ishquark13/Senior_Project/Documents/ocarina_link.gif

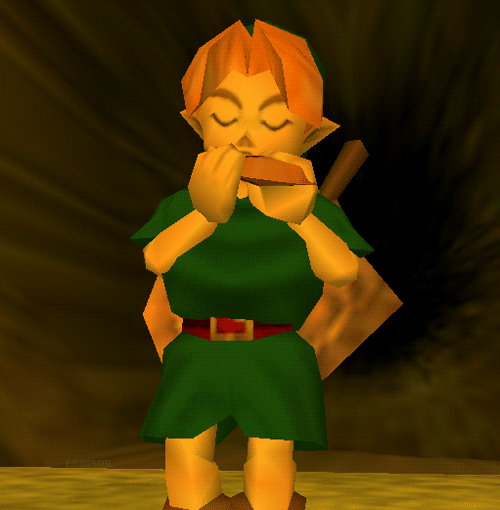
Documents/ocarina_link.gif
