ishquark13/Senior_Project/Hardware Projects/Sensors/Sensors.PcbDoc.htm

Reporting Options

# File in Previous Format

Date | : | 12/6/2017
Time | : | 8:59:06 PM
Filename | : | C:\Users\Adrian\Documents\GitHub\Senior_Project\Hardware Projects\Sensors\Sensors.PcbDoc

Version | Warning

This file was generated by an earlier version of the software
