ishquark13/Senior_Project/Hardware Projects/Senior_Project_PCB/DSP_Board.PcbDoc.htm

Reporting Options

# File in Previous Format

Date | : | 11/26/2017
Time | : | 10:20:54 AM
Filename | : | C:\Users\Adrian\Documents\GitHub\Senior_Project\Hardware Projects\Senior_Project_PCB\DSP_Board.PcbDoc

Version | Warning

This file was generated by an earlier version of the software
