ishquark13/Senior_Project/Hardware Projects/TMS320F28335GF/TMS320F28335GF.PcbDoc.htm

Reporting Options

# File in Previous Format

Date | : | 9/18/2017
Time | : | 1:07:27 PM
Filename | : | C:\Users\Adrian\Documents\GitHub\Senior_Project\TMS320F28335GF\TMS320F28335GF.PcbDoc

Version | Warning

This file was generated by an earlier version of the software
