ishquark13/Senior_Project/Hardware Projects/Senior_DoorLock/Project Outputs for Senior_DoorLock/Net Status - Senior_DoorLock.html

Altium customize

# Net Status Report

Date: | | 10/19/2017
Time: | | 2:37:35 AM
Elapsed Time: | | 00:00:00
Filename: | | C:\Users\Adrian\Altium\Projects\Senior_DoorLock\Senior_DoorLock.PcbDoc
Units: | | mmmils

Nets | Layer | Length
12.0V | Signal Layers Only | 0mils
5.0V | Signal Layers Only | 0mils
GND | Signal Layers Only | 0mils
Lock_Enable | Signal Layers Only | 0mils
MagSense | Signal Layers Only | 0mils
NetP3_2 | Signal Layers Only | 0mils
NetR1_1 | Signal Layers Only | 0mils
NetR1_2 | Signal Layers Only | 0mils
NetR2_1 | Signal Layers Only | 0mils
NetR2_2 | Signal Layers Only | 0mils

Back to top
