ishquark13/Senior_Project/Hardware Projects/Senior_Project_PCB/DSP_Board_AJA.PcbDoc.htm

Reporting Options

# File in Newer Format

Date | : | 12/7/2017
Time | : | 12:00:39 AM
Filename | : | C:\Users\Ish's Master Race PC\Documents\SeniorGithub\Senior_Project\Hardware Projects\Senior_Project_PCB\DSP_Board_AJA.PcbDoc

Version | Warning
Release 17.0 | CAUTION - Component parameters added.
Release 17.0 | CAUTION - Supports of backdrilling

This file was generated by a later version of the software
