ishquark13/Senior_Project/Documents/DSP_Flow.jpg

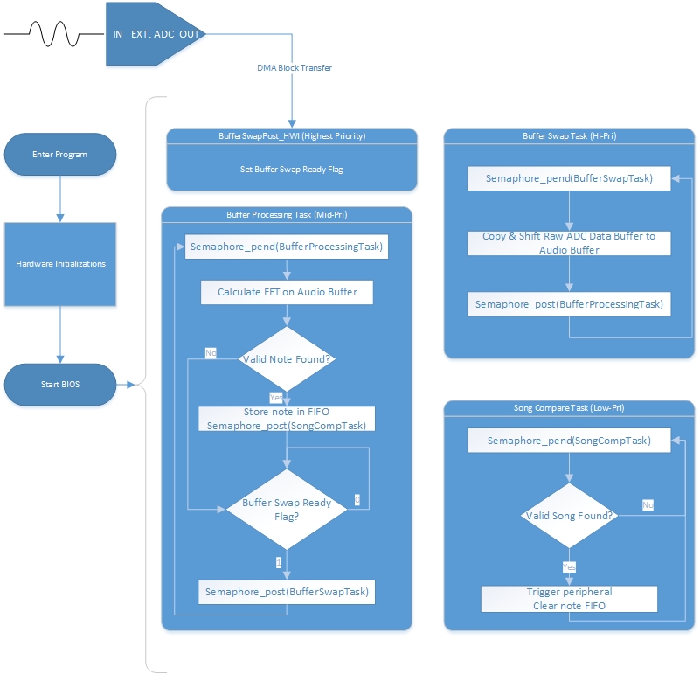
Documents/DSP_Flow.jpg
