ishquark13/Senior_Project/Documents/ESP_Flow.jpg

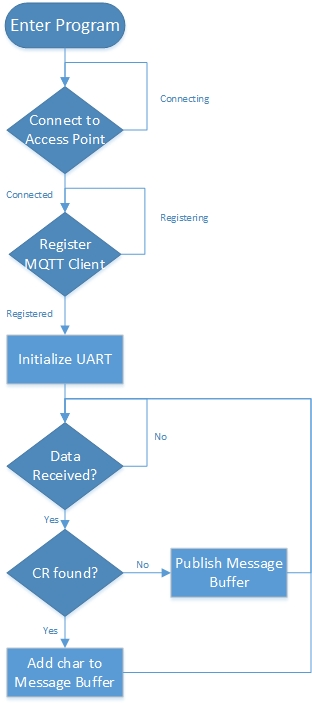
Documents/ESP_Flow.jpg
