ishquark13/Senior_Project/Documents/hardwareOverview.jpg

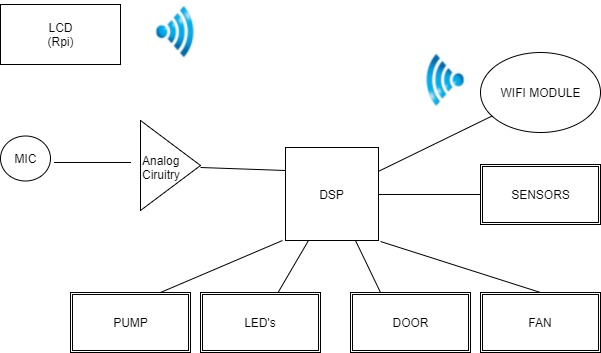
Documents/hardwareOverview.jpg
