ishquark13/Senior_Project/Hardware Projects/SolidWorks/Kokiri.png

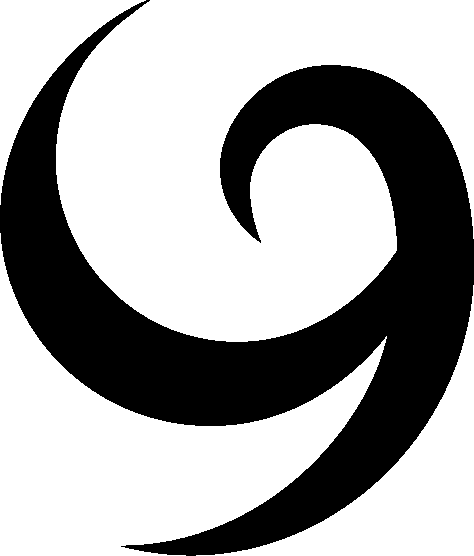
Hardware Projects/SolidWorks/Kokiri.png
