ishquark13/Senior_Project/Hardware Projects/SolidWorks/RoyalCrest.png

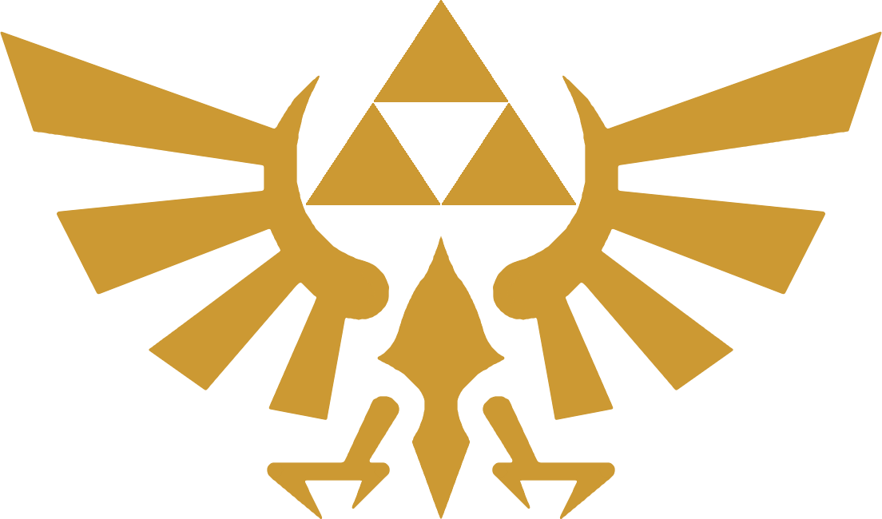
Hardware Projects/SolidWorks/RoyalCrest.png
