ishquark13/Senior_Project/Hardware Projects/SolidWorks/sword&shield.jpg

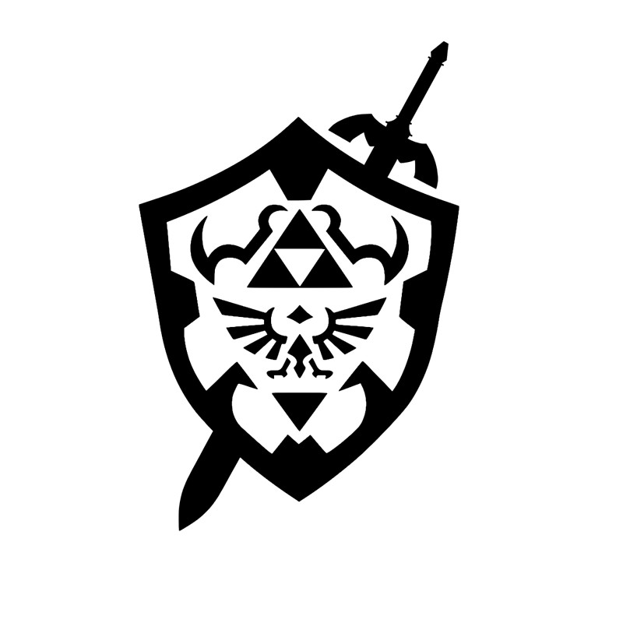
Hardware Projects/SolidWorks/sword&shield.jpg
