ishquark13/Senior_Project/Hardware Projects/SolidWorks/triforce.png

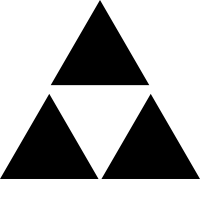
Hardware Projects/SolidWorks/triforce.png
