ishquark13/Senior_Project/Documents/partsList.xlsx

4xTL07 | **
resistors
capacitors
polarized caps
3.5mm audio jack
jumper wires
Pump | http://www.mouser.com/ProductDetail/Adafruit/1150/?qs=GURawfaeGuC56yozG16bcg%3D%3D
ADC | https://www.digikey.com/product-detail/en/ADS8320EB%2F2K5/296-38858-1-ND/5142976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 |  |  |  |  |  |  | **
Fan | https://www.amazon.com/ARCTIC-F12-Standard-Noise-Case/dp/B002KTVFTE?s=electronics
LED array | https://www.amazon.com/Super-Bright-RGB-LED-matrix/dp/B0068K01QE
DSP chip
Mic
Door Lock | https://www.amazon.com/dp/B012KISKU6?creative=395033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
LCD Disp
Bglebone
Item Number | Item Name | Footprint | Quantity | Purpose | Manufacturer | Source | Price
1 | TMS320F28335 | 176-Pin QFP | 1 | Digital Signal Processor | TI
2 | ADS8320 | MSOP-8 | 1 | Audio Sampler | TI
3 | TPS70351 | 24-Pin PowerPAD TSSOP | 1 | 5.0V to 3.3V/1.8V Power Delivery and Sequencing | TI
4 | Epson Oscillator | 4-Pin (Unique) | 1 | Oscillator Source for DSP Clock
5 |  |  | 2 | Audio BandPass Filter Op-Amps
6 |  |  | 1 | Audio PreAmp Op-Amps
7
8
9
10
11
12
13
14
15
16
17
18
19
20
