ishquark13/Senior_Project/Hardware Projects/SolidWorks/HomeModel.SLDASM

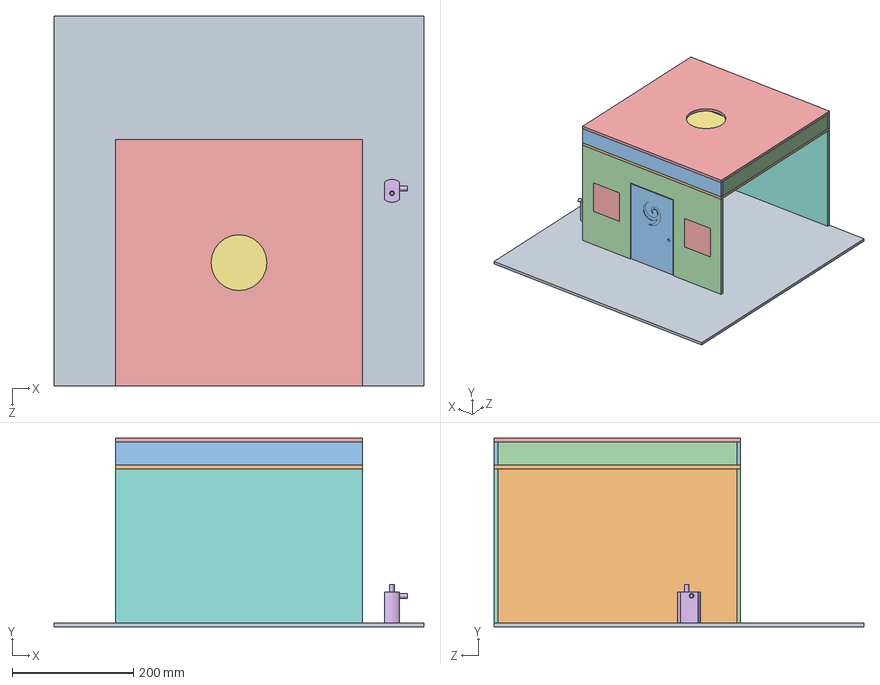
[picture p21: CAD file, 2017-11-25]
Hardware Projects/SolidWorks/HomeModel.SLDASM
609.6 x 311.1 x 609.6 mm
BaseBoard
Ceiling
FrontDoor
FrontWall
FrontWindow x 2
DSP_Board_AJA
Fan
BackWall
Senior_DoorLock
SideWall
RoofFrontBack x 2
RoofSide x 2
RoofTop
Pump
