ishquark13/Senior_Project/Hardware Projects/Senior_DoorLock/Senior_DoorLock.step

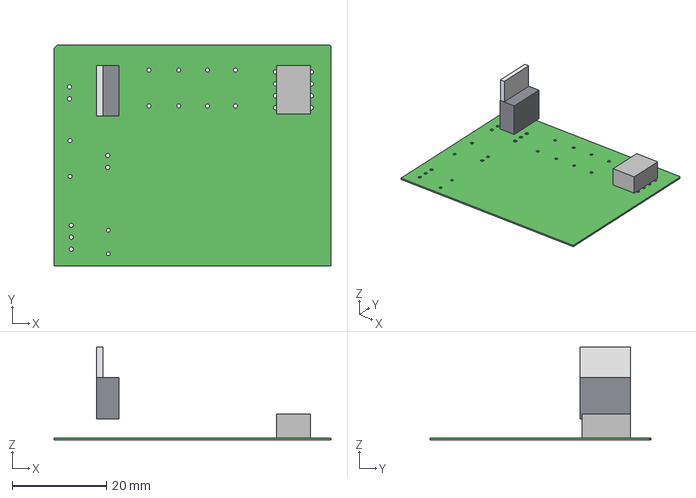
[picture p22: CAD file, 2017-11-25]
Hardware Projects/Senior_DoorLock/Senior_DoorLock.step
58.9 x 47.0 x 19.7 mm
