ishquark13/Senior_Project/Hardware Projects/Senior_Project_PCB/DSP_Board_AJA.step

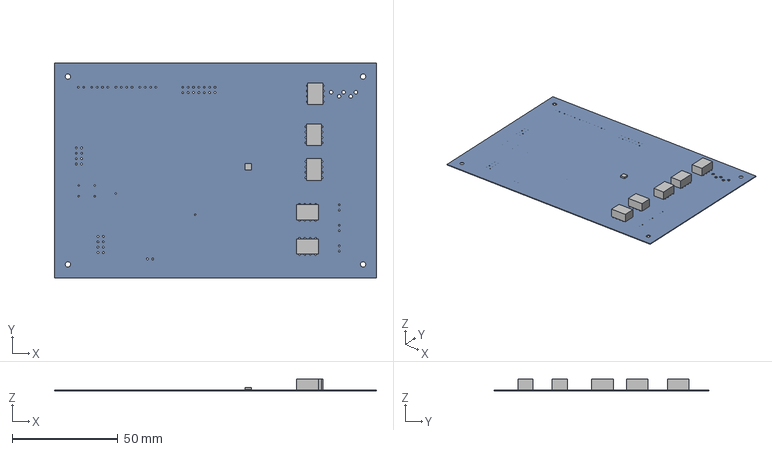
[picture p23: CAD file, 2017-11-15]
Hardware Projects/Senior_Project_PCB/DSP_Board_AJA.step
152.4 x 101.6 x 5.49 mm
