ishquark13/Senior_Project/Hardware Projects/SolidWorks/RoofSide.SLDPRT

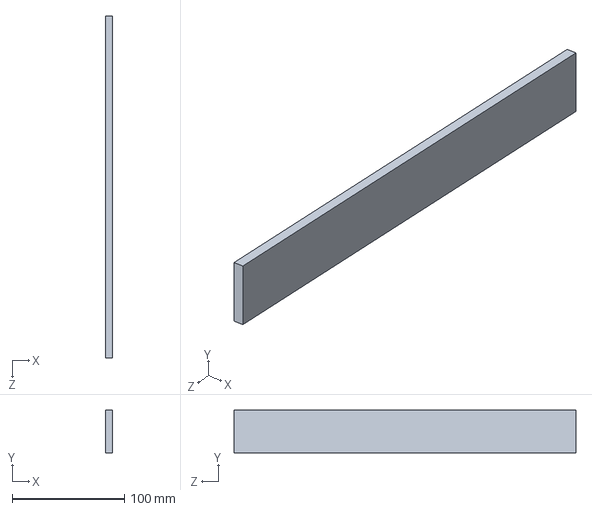
[picture p24: CAD file, 2017-12-04]
Hardware Projects/SolidWorks/RoofSide.SLDPRT
6.35 x 38.1 x 304.8 mm
