ishquark13/Senior_Project/Hardware Projects/SolidWorks/RoofTop.SLDPRT

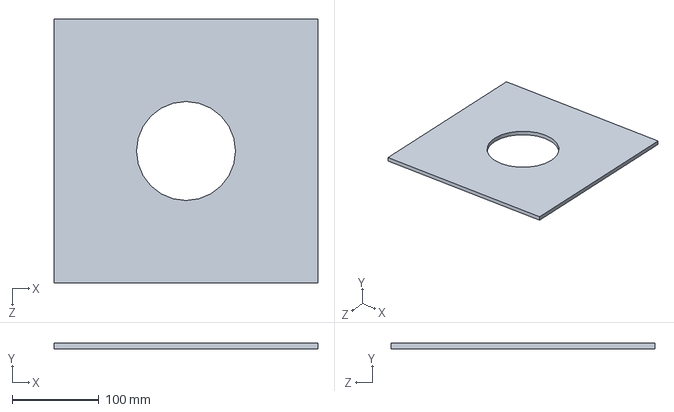
[picture p25: CAD file, 2017-12-04]
Hardware Projects/SolidWorks/RoofTop.SLDPRT
304.8 x 6.35 x 304.8 mm
