ishquark13/Senior_Project/Hardware Projects/SolidWorks/FrontDoor.SLDPRT

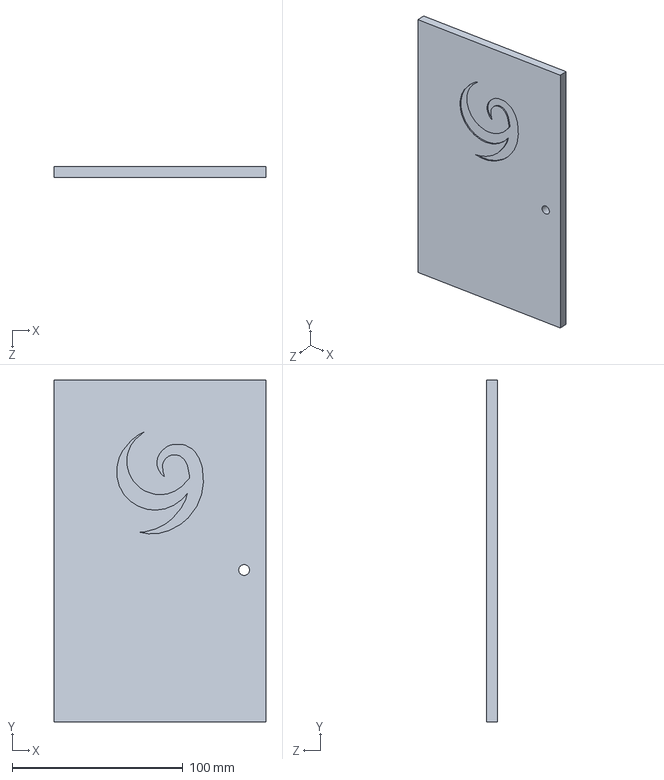
[picture p26: CAD file, 2017-11-25]
Hardware Projects/SolidWorks/FrontDoor.SLDPRT
123.8 x 200.0 x 6.35 mm
