ishquark13/Senior_Project/Hardware Projects/SolidWorks/Fan.SLDPRT

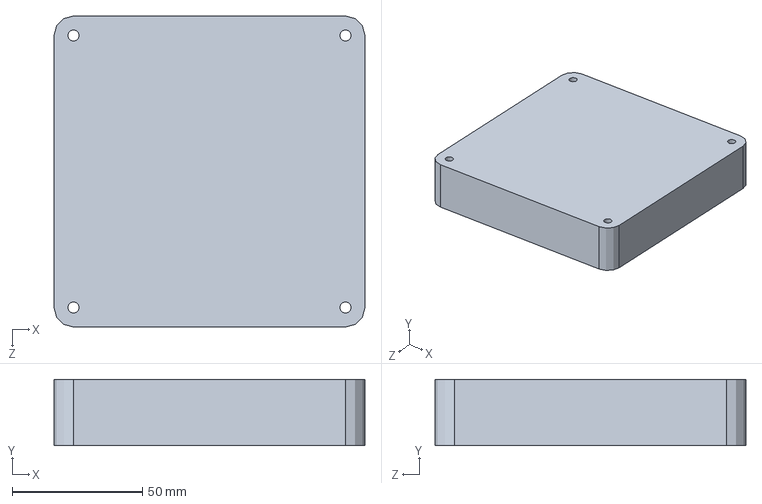
[picture p27: CAD file, 2017-11-25]
Hardware Projects/SolidWorks/Fan.SLDPRT
119.4 x 25.4 x 119.4 mm
