ishquark13/Senior_Project/Hardware Projects/SolidWorks/RoofFrontBack.SLDPRT

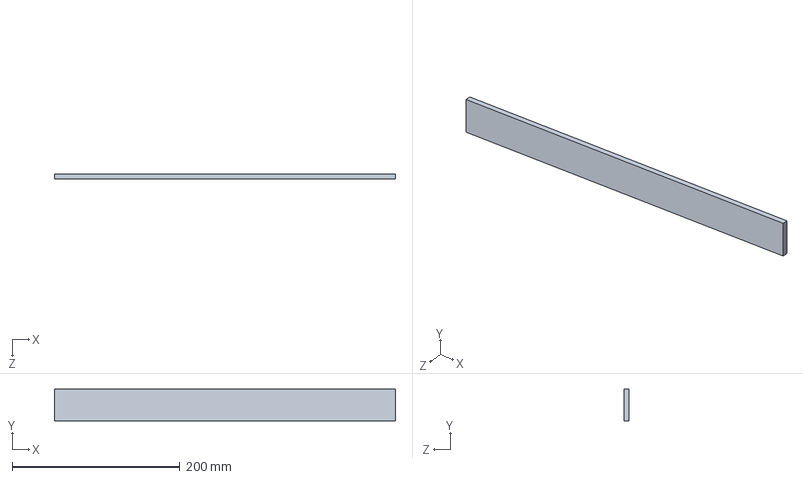
[picture p28: CAD file, 2017-11-25]
Hardware Projects/SolidWorks/RoofFrontBack.SLDPRT
406.4 x 38.1 x 6.35 mm
