ishquark13/Senior_Project/Hardware Projects/SolidWorks/Ceiling.SLDPRT

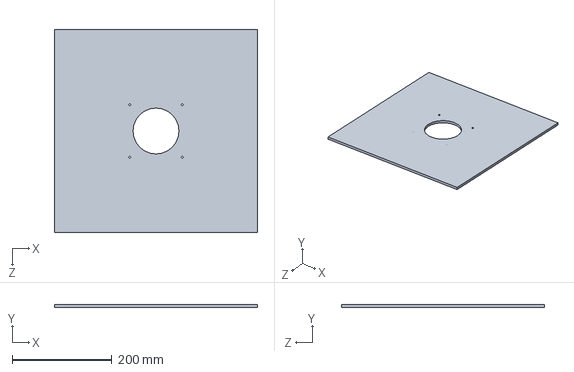
[picture p29: CAD file, 2017-11-25]
Hardware Projects/SolidWorks/Ceiling.SLDPRT
406.4 x 6.35 x 406.4 mm
