ishquark13/Senior_Project/Hardware Projects/SolidWorks/BackWall.SLDPRT

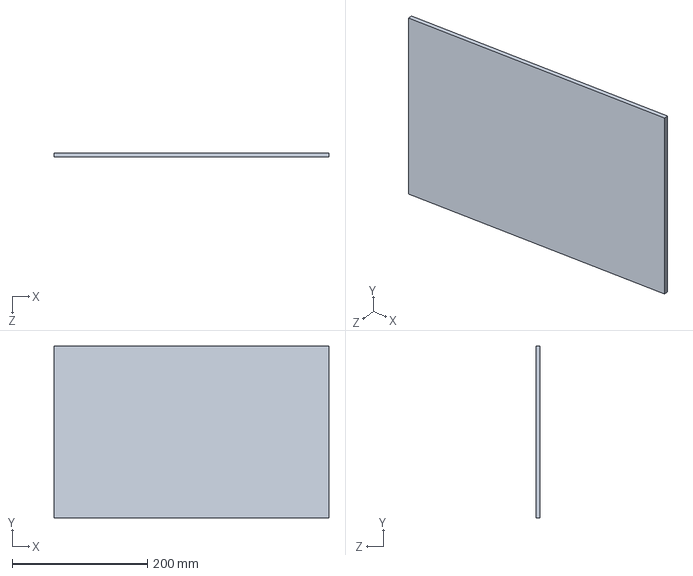
[picture p30: CAD file, 2017-11-25]
Hardware Projects/SolidWorks/BackWall.SLDPRT
406.4 x 254.0 x 6.35 mm
