ishquark13/Senior_Project/Hardware Projects/SolidWorks/BaseBoard.SLDPRT

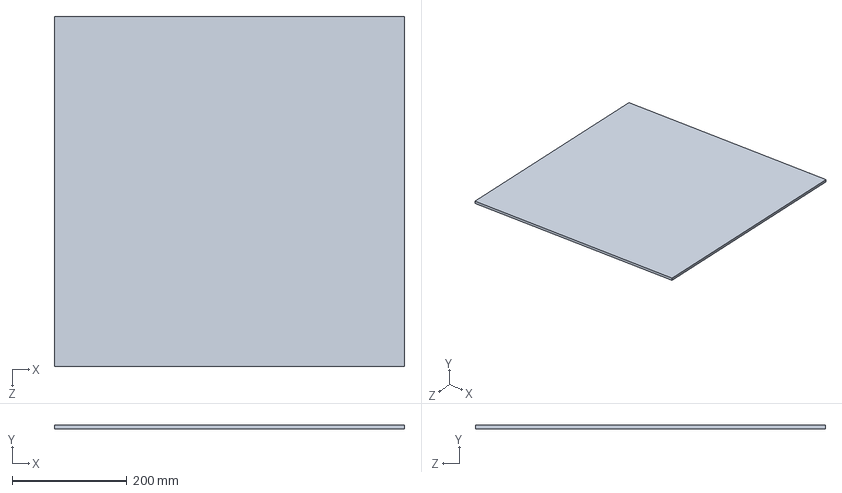
[picture p31: CAD file, 2017-11-25]
Hardware Projects/SolidWorks/BaseBoard.SLDPRT
609.6 x 6.35 x 609.6 mm
