ishquark13/Senior_Project/Hardware Projects/SolidWorks/SideWall.SLDPRT

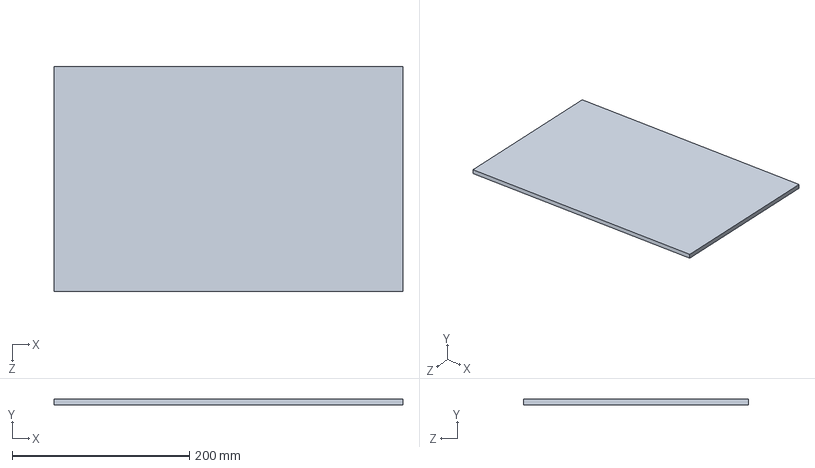
[picture p32: CAD file, 2017-11-25]
Hardware Projects/SolidWorks/SideWall.SLDPRT
393.7 x 6.35 x 254.0 mm
