ishquark13/Senior_Project/Hardware Projects/SolidWorks/FrontWall.SLDPRT

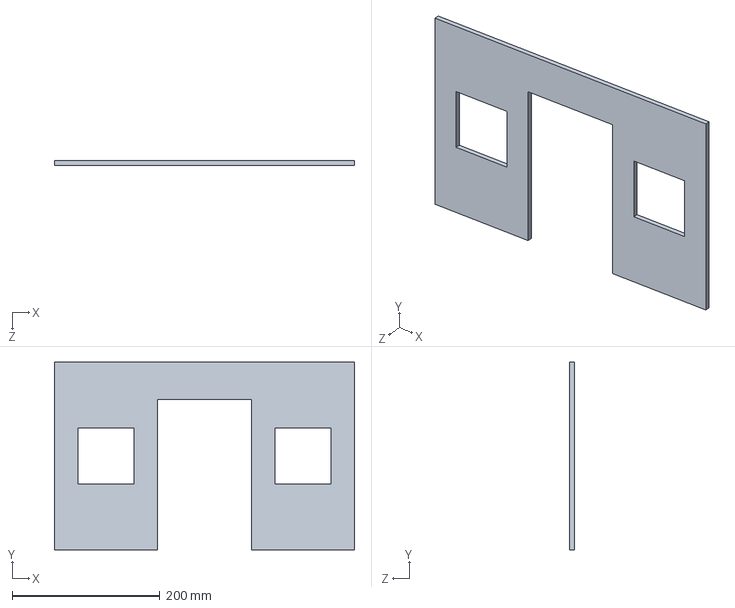
[picture p33: CAD file, 2017-11-25]
Hardware Projects/SolidWorks/FrontWall.SLDPRT
406.4 x 254.0 x 6.35 mm
