ishquark13/Senior_Project/Hardware Projects/SolidWorks/FrontWindow.SLDPRT

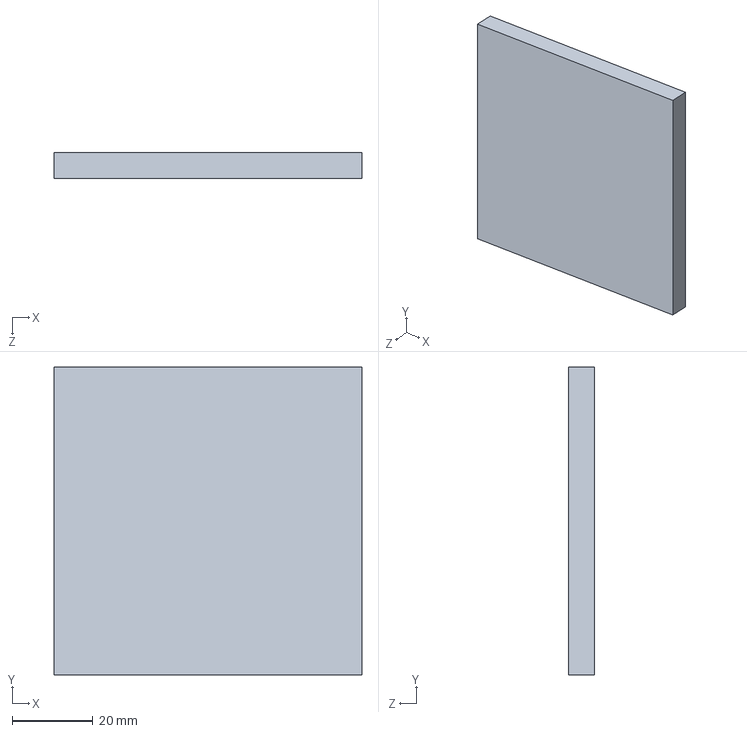
[picture p34: CAD file, 2017-11-25]
Hardware Projects/SolidWorks/FrontWindow.SLDPRT
76.2 x 76.2 x 6.35 mm
