ishquark13/Senior_Project/Hardware Projects/SolidWorks/Pump.SLDPRT

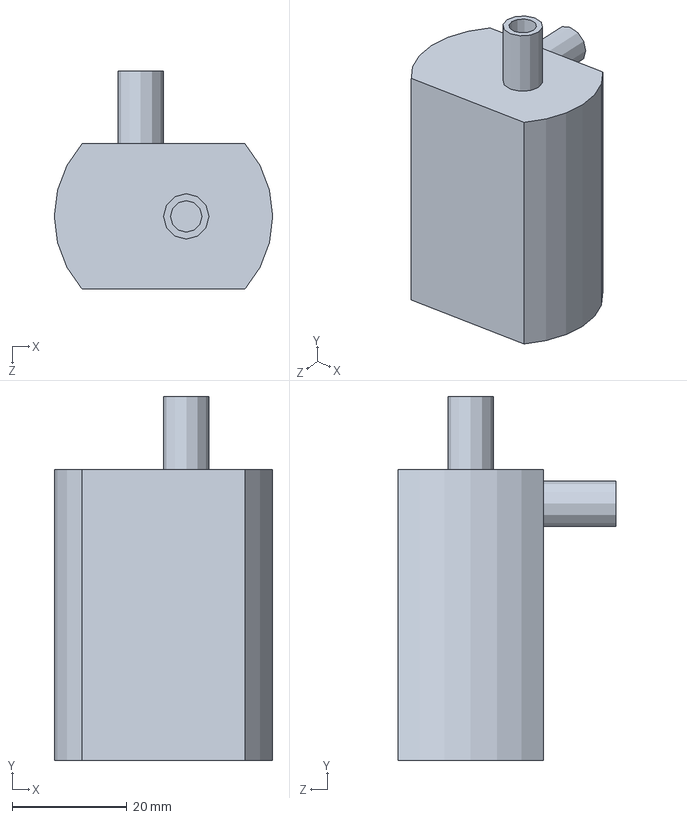
[picture p35: CAD file, 2017-11-25]
Hardware Projects/SolidWorks/Pump.SLDPRT
38.1 x 63.5 x 38.1 mm
