ishquark13/Senior_Project/(list of files, cad)

Other CAD files:
Software Projects/Ocarina_Home_Automation/src/sysbios/c28_Hwi_asm.obj
Software Projects/Ocarina_Home_Automation/src/sysbios/c28_TaskSupport_asm.obj
Software Projects/Ocarina_Home_Automation/src/sysbios/c28_IntrinsicsSupport_asm.obj
Software Projects/Ocarina_Home_Automation/src/sysbios/c28_Hwi_disp_asm.obj
Software Projects/Ocarina_Home_Automation/Debug/Common/DSP2833x_Spi.obj
Software Projects/Ocarina_Home_Automation/Debug/EEL4511 Libraries/src/EEL4511_CircBuff.obj
Software Projects/Ocarina_Home_Automation/Debug/RFFT/RFFT_f32s_mag.obj
Software Projects/Ocarina_Home_Automation/Debug/Common/DSP2833x_DMA.obj
Software Projects/Ocarina_Home_Automation/Debug/EEL4511 Libraries/src/EEL4511_MISC.obj
Software Projects/Ocarina_Home_Automation/Debug/RFFT/RFFT_f32.obj
Software Projects/Ocarina_Home_Automation/Debug/Common/DSP2833x_ADC_cal.obj
Software Projects/Ocarina_Home_Automation/Debug/EEL4511 Libraries/src/EEL4511_ADC.obj
Software Projects/Ocarina_Home_Automation/Debug/RFFT/RFFT_f32_sincostable.obj
Hardware Projects/SolidWorks/Senior_DoorLock.SLDPRT
Software Projects/Ocarina_Home_Automation/Debug/Common/DSP2833x_DefaultIsr.obj
Software Projects/Ocarina_Home_Automation/Debug/EEL4511 Libraries/src/EEL4511_GPIO.obj
Software Projects/Ocarina_Home_Automation/Debug/RFFT/RFFT_f32_phase.obj
Software Projects/Ocarina_Home_Automation/src/sysbios/BIOS.obj
Software Projects/Ocarina_Home_Automation/Debug/Common/DSP2833x_Mcbsp.obj
Software Projects/Ocarina_Home_Automation/Debug/EEL4511 Libraries/src/EEL4511_LCD.obj
Software Projects/Ocarina_Home_Automation/Debug/RFFT/RFFT_f32_mag.obj
Software Projects/Ocarina_Home_Automation/Debug/Common/DSP2833x_Adc.obj
Software Projects/Ocarina_Home_Automation/Debug/EEL4511 Libraries/src/EEL4511_SRAM.obj
Software Projects/Ocarina_Home_Automation/Debug/RFFT/RFFT_adc_f32.obj
Software Projects/Ocarina_Home_Automation/Debug/Common/DSP2833x_Xintf.obj
Software Projects/Ocarina_Home_Automation/Debug/EEL4511 Libraries/src/actuatorControl.obj
Software Projects/Ocarina_Home_Automation/Debug/RFFT/RFFT_adc_f32u.obj
Software Projects/Ocarina_Home_Automation/Debug/Common/DSP2833x_usDelay.obj
Software Projects/Ocarina_Home_Automation/Debug/EEL4511 Libraries/src/EEL4511_DAC.obj
Software Projects/Ocarina_Home_Automation/Debug/RFFT/RFFT_f32u.obj
Software Projects/Ocarina_Home_Automation/Debug/Common/DSP2833x_MemCopy.obj
Software Projects/Ocarina_Home_Automation/Debug/EEL4511 Libraries/src/USARTinit.obj
Software Projects/Ocarina_Home_Automation/Debug/Common/DSP2833x_I2C.obj
Software Projects/Ocarina_Home_Automation/Debug/EEL4511 Libraries/src/OneToOneI2CDriver.obj
Hardware Projects/SolidWorks/DSP_Board_AJA.SLDPRT
Software Projects/Ocarina_Home_Automation/Debug/Common/DSP2833x_Gpio.obj
Software Projects/Ocarina_Home_Automation/Debug/Common/DSP2833x_CpuTimers.obj
Software Projects/Ocarina_Home_Automation/Debug/Common/DSP2833x_Sci.obj
Software Projects/Ocarina_Home_Automation/Debug/Common/DSP2833x_SysCtrl.obj
Software Projects/Ocarina_Home_Automation/Debug/Common/DSP2833x_EPwm.obj
Software Projects/Ocarina_Home_Automation/Debug/Common/DSP2833x_GlobalVariableDefs.obj
Software Projects/Ocarina_Home_Automation/Debug/EEL4511 Libraries/EEL4511_ADC.obj
Software Projects/Ocarina_Home_Automation/Debug/EEL4511 Libraries/EEL4511_CircBuff.obj
Software Projects/Ocarina_Home_Automation/Debug/EEL4511 Libraries/EEL4511_DAC.obj
Software Projects/Ocarina_Home_Automation/Debug/EEL4511 Libraries/EEL4511_GPIO.obj
Software Projects/Ocarina_Home_Automation/Debug/EEL4511 Libraries/EEL4511_LCD.obj
Software Projects/Ocarina_Home_Automation/Debug/EEL4511 Libraries/EEL4511_MISC.obj
Software Projects/Ocarina_Home_Automation/Debug/EEL4511 Libraries/EEL4511_SRAM.obj
Software Projects/Ocarina_Home_Automation/Debug/EEL4511 Libraries/OneToOneI2CDriver.obj
