ishquark13/Senior_Project/Hardware Projects/Senior_Project_PCB/PCB_Printout.pdf

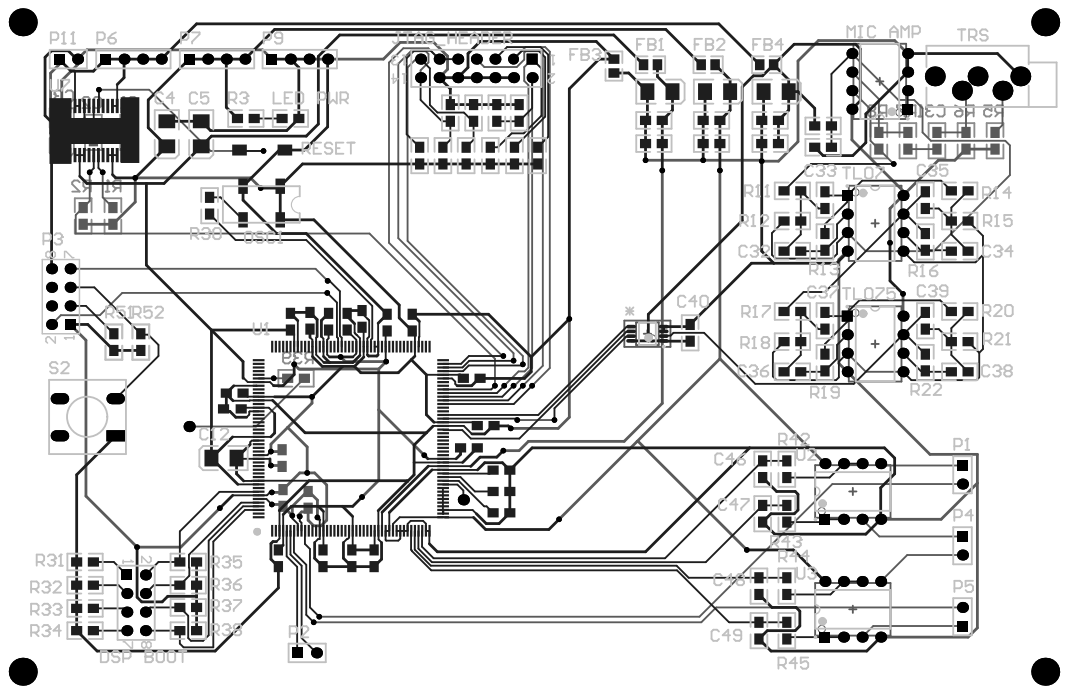
[picture p36: page 1]
