ishquark13/Senior_Project/Documents/Flowchart_v1.pdf

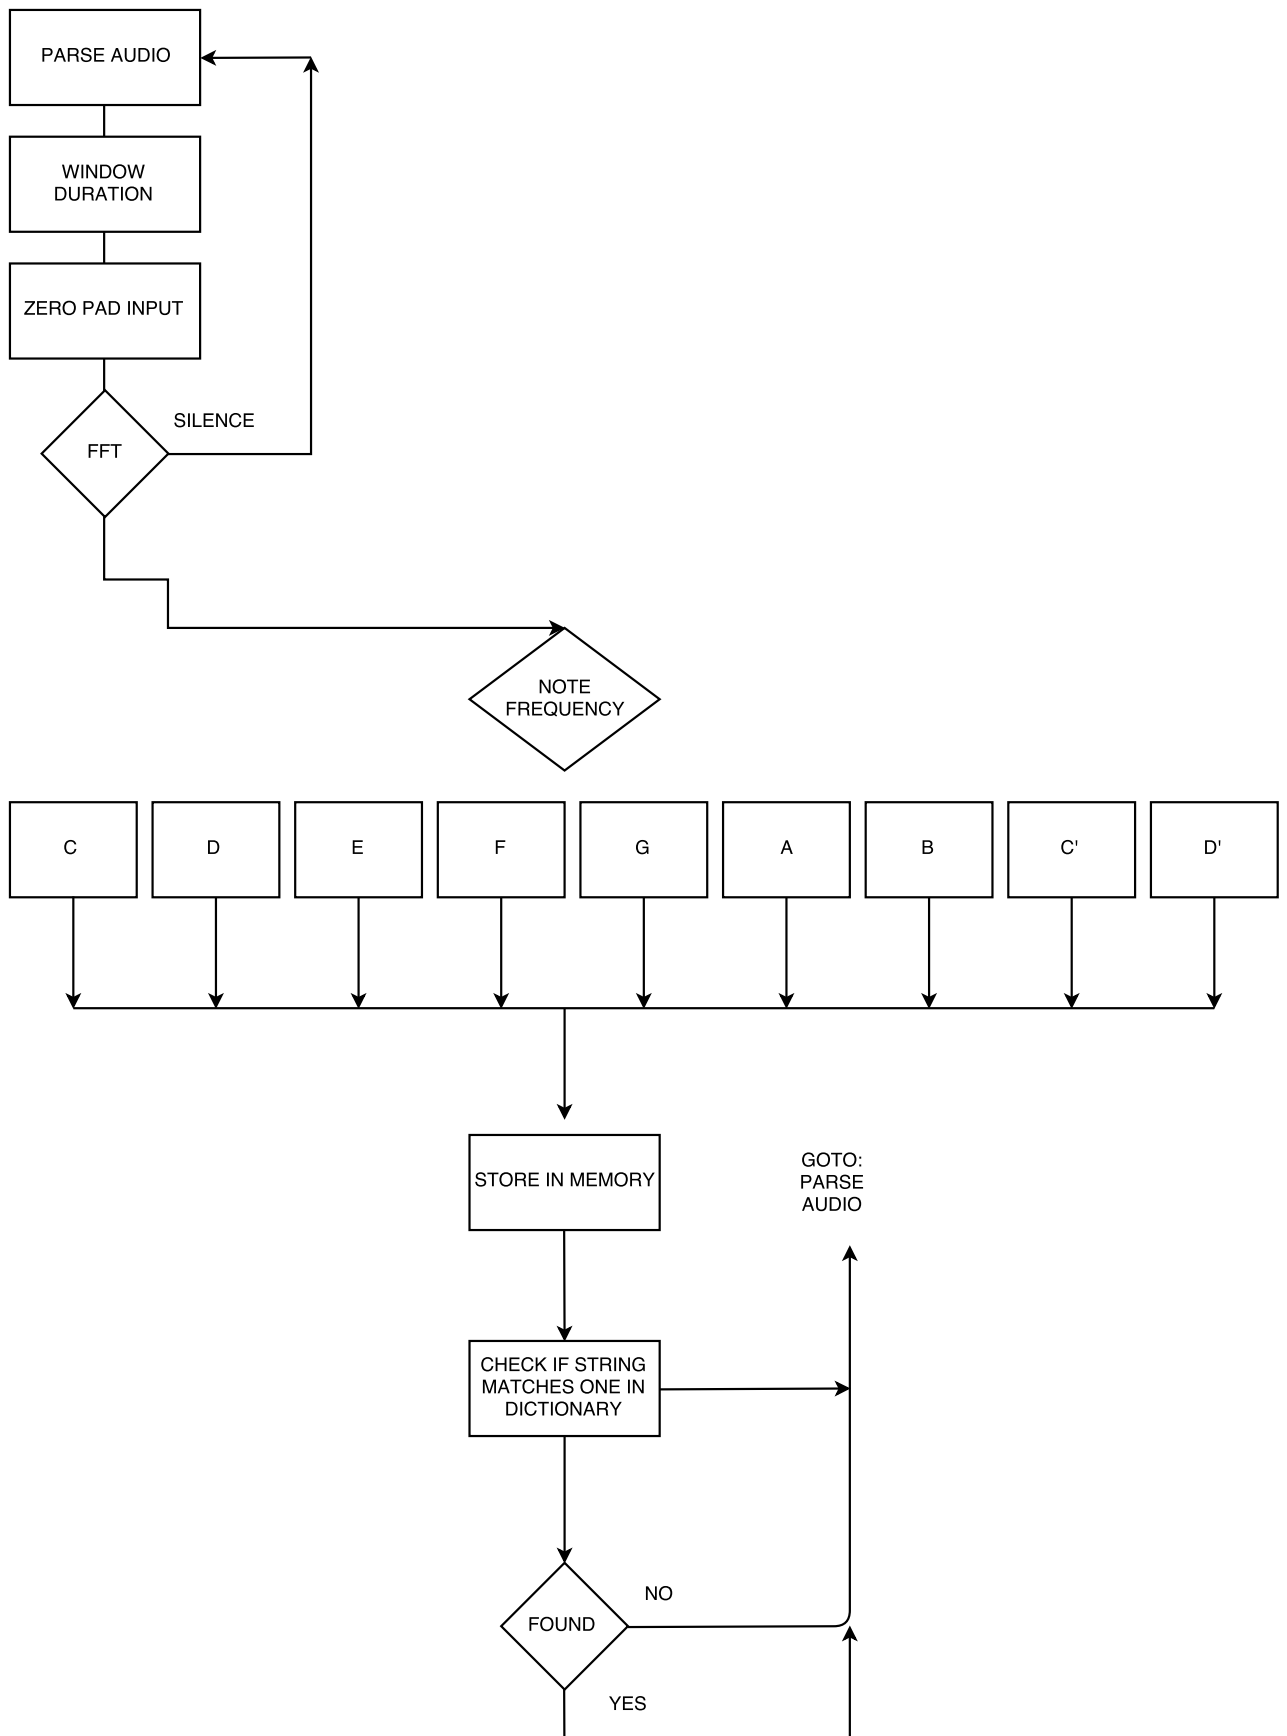
[picture p37: page 1]

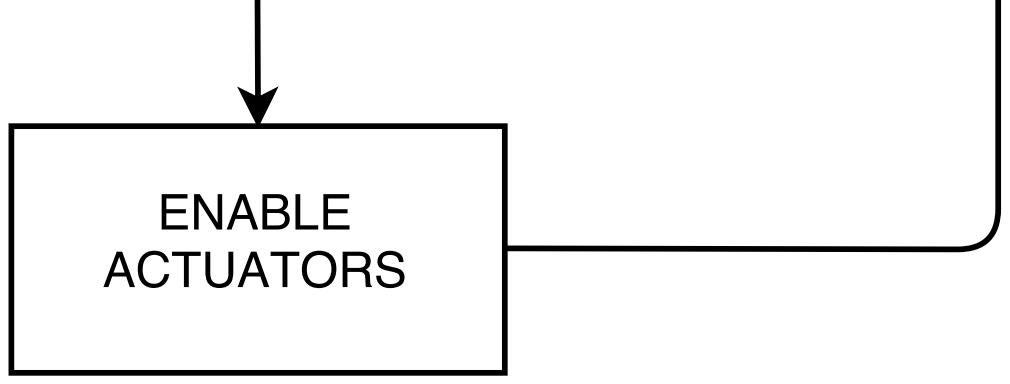
[picture p38: page 2]
