ishquark13/Senior_Project/(list of files, drawings)

Other design files:
Hardware Projects/Senior_Analog_PCB/CLASS_AB.PcbDoc
Hardware Projects/Senior_Analog_PCB/CLASS_AB.SchDoc
Hardware Projects/Senior_Analog_PCB/Senior_Analog_PCB.PrjPcb
Hardware Projects/Senior_DoorLock/AD22151.SchLib
Hardware Projects/Senior_DoorLock/Senior_DoorLock.PcbDoc
Hardware Projects/Senior_DoorLock/Senior_DoorLock.PrjPcb
Hardware Projects/Senior_DoorLock/Senior_DoorLock.SchDoc
Hardware Projects/Senior_Project_PCB/8VSSOP.PcbLib
Hardware Projects/Senior_Project_PCB/ADC/Schlib1.SchLib
Hardware Projects/Senior_Project_PCB/Audio_ADC.SchDoc
Hardware Projects/Senior_Project_PCB/DSP_Board.PcbDoc
Hardware Projects/Senior_Project_PCB/DSP_Board.SchDoc
Hardware Projects/Senior_Project_PCB/DSP_Board_AJA.PcbDoc
Hardware Projects/Senior_Project_PCB/DSP_Board_Headers.SchDoc
Hardware Projects/Senior_Project_PCB/DSP_Power.SchDoc
Hardware Projects/Senior_Project_PCB/PowerBreakout.SchDoc
Hardware Projects/Senior_Project_PCB/Senior_Project_PCB.PrjPcb
Hardware Projects/Senior_Project_PCB/TMS320F28335_DSP.SchDoc
Hardware Projects/Sensors/Sensors.PcbDoc
Hardware Projects/Sensors/Sensors.PrjPcb
Hardware Projects/Sensors/Sensors.SchDoc
Hardware Projects/TMS320F28335GF/C283x_DSP.SchDoc
Hardware Projects/TMS320F28335GF/F28335_AddOn_Memory.SchDoc
Hardware Projects/TMS320F28335GF/F28335_CPLD.SchDoc
Hardware Projects/TMS320F28335GF/F28335_FanOut.SchDoc
Hardware Projects/TMS320F28335GF/F28335_Level_Shifters.SchDoc
Hardware Projects/TMS320F28335GF/F28335_USB_and_Nordic.SchDoc
Hardware Projects/TMS320F28335GF/Main.SchDoc
Hardware Projects/TMS320F28335GF/Power.SchDoc
Hardware Projects/TMS320F28335GF/TMS320F28335GF1/SFE-Custom-Footprints.PcbLib
Hardware Projects/TMS320F28335GF/TMS320F28335GF1/TMS320F28335GF.PcbLib
Hardware Projects/TMS320F28335GF/TMS320F28335GF1/TMS320F28335GF.SCHLIB
Hardware Projects/TMS320F28335GF/TMS320F28335GF2/SFE-Custom-Footprints.PcbLib
Hardware Projects/TMS320F28335GF/TMS320F28335GF2/TMS320F28335GF.PcbLib
Hardware Projects/TMS320F28335GF/TMS320F28335GF2/TMS320F28335GF.SCHLIB
Hardware Projects/TMS320F28335GF/TMS320F28335GF.PcbDoc
Hardware Projects/TMS320F28335GF/TMS320F28335GF.PrjPcb
Hardware Projects/TMS320F28335GF/TMS320F28335GF.SchDoc
Hardware Projects/TMS320F28335GF/XDS_100_USB_Programmer.SchDoc
