ishquark13/Senior_Project/Software Projects/Ocarina_Home_Automation/EEL4511 Libraries/include/hammingWindow.h

/*
 * hammingWindow.h
 *
 *  Created on: Oct 15, 2015
 *      Author: Raz Aloni
 */

#ifndef HAMMINGWINDOW_H_
#define HAMMINGWINDOW_H_

extern float hamming[1024]=
{
	0.08,
	0.0800086763,
	0.0800347049,
	0.0800780848,
	0.0801388144,
	0.0802168913,
	0.0803123127,
	0.0804250749,
	0.0805551737,
	0.0807026042,
	0.0808673608,
	0.0810494372,
	0.0812488268,
	0.0814655218,
	0.0816995141,
	0.0819507949,
	0.0822193548,
	0.0825051836,
	0.0828082704,
	0.083128604,
	0.0834661722,
	0.0838209622,
	0.0841929606,
	0.0845821536,
	0.0849885263,
	0.0854120634,
	0.085852749,
	0.0863105664,
	0.0867854984,
	0.087277527,
	0.0877866337,
	0.0883127993,
	0.0888560039,
	0.089416227,
	0.0899934476,
	0.0905876438,
	0.0911987932,
	0.0918268727,
	0.0924718588,
	0.093133727,
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
};

#endif /* HAMMINGWINDOW_H_ */
