ishquark13/Senior_Project/Software Projects/ADC_names.cpp

#include "DSP28x_Project.h"     // Device Headerfile and Examples Include File

// ADC start parameters
#if (CPU_FRQ_150MHZ)     // Default - 150 MHz SYSCLKOUT
  #define ADC_MODCLK 0x3 // HSPCLK = SYSCLKOUT/2*ADC_MODCLK2 = 150/(2*3)   = 25.0 MHz
#endif
#if (CPU_FRQ_100MHZ)
  #define ADC_MODCLK 0x2 // HSPCLK = SYSCLKOUT/2*ADC_MODCLK2 = 100/(2*2)   = 25.0 MHz
#endif
#define ADC_CKPS   0x1   // ADC module clock = HSPCLK/2*ADC_CKPS   = 25.0MHz/(1*2) = 12.5MHz
#define ADC_SHCLK  0xf   // S/H width in ADC module periods                        = 16 ADC clocks
#define AVG        1000  // Average sample limit
#define ZOFFSET    0x00  // Average Zero offset
#define BUF_SIZE   2048  // Sample buffer size
