ishquark13/Senior_Project/Software Projects/Ocarina_Home_Automation/EEL4511 Libraries/include/EEL4511.h

/*
 * EEL4511.h
 *
 *  Created on: Oct 17, 2016
 *      Author: Adrian
 */

#ifndef EEL4511_H_
#define EEL4511_H_

#include "EEL4511_ADC.h"
#include "EEL4511_CircBuff.h"
#include "EEL4511_DAC.h"
#include "EEL4511_GPIO.h"
#include "EEL4511_LCD.h"
#include "EEL4511_MISC.h"
#include "EEL4511_SRAM.h"
#include "OneToOneI2CDriver.h"
#include "USARTinit.h"


#endif /* EEL4511_H_ */
