ishquark13/Senior_Project/Software Projects/Ocarina_Home_Automation/EEL4511 Libraries/include/USARTinit.h

#ifndef USART
#define USART

/*** p r o t o t y p e s ***/

__interrupt void inCharISR();

void interruptInit();
void timerInit();
void outChar(char c);
void outWord(char* word);
void outPayload(char payload[], int len);
void USARTinit();
void USARTtest();
void startUSART();

#endif
