ishquark13/Senior_Project/Software Projects/Ocarina_Home_Automation/EEL4511 Libraries/include/EEL4511_LCD.h

/*
 * EEL4511_LCD.h
 *
 *  Created on: Oct 17, 2016
 *      Author: Adrian
 */
#include<DSP28x_Project.h>

#ifndef EEL4511_LCD_H_
#define EEL4511_LCD_H_

void Init_LCD(void);
void LCD_command(char val);
void LCD_char(char val);
void LCD_clear(void);
void LCD_string(char* string);
void LCD_float( float value);
void LCD_home(void);
void LCD_pos(short unsigned int row, short unsigned int col);

#endif /* EEL4511_LCD_H_ */
