ishquark13/Senior_Project/Software Projects/Ocarina_Home_Automation/EEL4511 Libraries/include/EEL4511_ADC.h

/*
 * EEL4511_ADC.h
 *
 *  Created on: Oct 17, 2016
 *      Author: Adrian
 */

#ifndef EEL4511_ADC_H_
#define EEL4511_ADC_H_

void Init_McBSPb_ADC(void);
Uint16 ADC_in(void);

#endif /* EEL4511_ADC_H_ */
