ishquark13/Senior_Project/Software Projects/Ocarina_Home_Automation/EEL4511 Libraries/include/EEL4511_DAC.h

/*
 * EEL4511_DAC.h
 *
 *  Created on: Oct 17, 2016
 *      Author: Adrian
 */

#ifndef EEL4511_DAC_H_
#define EEL4511_DAC_H_

void Init_McBSPa_DAC(void);
void DAC_out(Uint16 value);

#endif /* EEL4511_DAC_H_ */
