ishquark13/Senior_Project/Software Projects/Ocarina_Home_Automation/EEL4511 Libraries/include/EEL4511_GPIO.h

/*
 * EEL4511_GPIO.h
 *
 *  Created on: Oct 18, 2016
 *      Author: Adrian
 */

#ifndef EEL4511_GPIO_H_
#define EEL4511_GPIO_H_

void Init_LED(void);
void Init_SWITCH(void);
Uint16 SWITCH_read(void);


#endif /* EEL4511_GPIO_H_ */
