ishquark13/Senior_Project/(commit log)

2017-01-29 Task Demo for DSP
    [BIOS.obj, build.cfg, c28_Hwi_asm.obj, c28_Hwi_disp_asm.obj, c28_IntrinsicsSupport_asm.obj, c28_TaskSupport_asm.obj, mutex.cfg, mutex_p28FP.cfg]
2017-04-06 PID using libraries
    NOTE: Will link a document by TI that explains a consistent workflow for
    this PID controller
2017-08-29 Added Flowchart_v1.pdf
2017-08-30 Removed Task demo
    [BIOS.obj, build.cfg, c28_Hwi_asm.obj, c28_Hwi_disp_asm.obj, c28_IntrinsicsSupport_asm.obj, c28_TaskSupport_asm.obj, mutex.cfg, mutex_p28FP.cfg]
2017-08-30 Organized & Added Ocarina_Home_Automation
    [app.cfg, app_p28FP.cfg, build.cfg]
2017-08-31 Update Project and PDR
    Added Libraries and Drivers from EEL4511
    [BIOS.obj, DSP2833x_ADC_cal.obj, DSP2833x_Adc.obj, DSP2833x_CpuTimers.obj, DSP2833x_DMA.obj, DSP2833x_DefaultIsr.obj, DSP2833x_EPwm.obj, DSP2833x_GlobalVariableDefs.obj]
2017-08-31 Compatibility changes and "clean" build
    Edited the controlSUITE Timer driver to ensure compatibility with RTOS.
    Cleaned the project to remove unnecessary build files from entering the
    git
    [BIOS.obj, DSP2833x_ADC_cal.obj, DSP2833x_Adc.obj, DSP2833x_CpuTimers.obj, DSP2833x_DMA.obj, DSP2833x_DefaultIsr.obj, DSP2833x_EPwm.obj, DSP2833x_GlobalVariableDefs.obj]
2017-08-31 changed pdr
    update pdr and the PID
2017-09-05 GIF, Gantt, and PDR changes (revIP)
    [Gantt_Chart.xlsx]
2017-09-06 Uploaded powerpoint
    Class presentation document
2017-09-06 Docs update
    [Gantt_Chart.xlsx]
2017-09-06 Update powerpoint and PDR
    Final update
2017-09-06 Doc Updates
    [Gantt_Chart.xlsx]
2017-09-06 Update Docs for Presentation
    [Gantt_Chart.xlsx]
2017-09-14 Added DSP Board Reference Schematics
    [C283x_DSP.SchDoc, F28335_AddOn_Memory.SchDoc, F28335_FanOut.SchDoc, F28335_Level_Shifters.SchDoc, F28335_USB_and_Nordic.SchDoc, Main.SchDoc, Power.SchDoc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]
2017-09-15 Added Library Headers
    [EEL4511_ADC.obj, EEL4511_CircBuff.obj, EEL4511_DAC.obj, EEL4511_GPIO.obj, EEL4511_LCD.obj, EEL4511_MISC.obj, EEL4511_SRAM.obj, OneToOneI2CDriver.obj]
2017-09-20 Docs, PCB Project, DSP Code Updates
    Added some data sheets.
    Created PCB project, mostly empty sheets
    PingPong Buffering Scheme now works with the BIOS, still need to clean
    the code though.
    [Audio_ADC.SchDoc, DSP_Board.SchDoc, DSP_Board_Headers.SchDoc, PowerDesign.SchDoc, Senior_Project_PCB.PrjPcb, TMS320F28335_DSP.SchDoc, UART_Breakout.SchDoc, XDS100_Breakout.SchDoc]
2017-09-20 added ADC
    internal adc on channel 0
2017-09-29 added the ADC schematic and footprint
    update PCB with audio capture source finished
    [Audio_ADC.CSV, Audio_ADC.SchDoc, Schlib1.SchLib, Senior_Project_PCB.PrjPcb]
2017-10-02 Docs and schematics
    [C283x_DSP.SchDoc]
2017-10-02 excel parts list
    add parts list
    [Audio_ADC.SchDoc, partsList.xlsx]
2017-10-02 Schematics Update
    [DSP_Board.SchDoc, DSP_Power.SchDoc, PowerBreakout.SchDoc, Senior_Project_PCB.PrjPcb, TMS320F28335_DSP.SchDoc, UART_Breakout.SchDoc, XDS100_Breakout.SchDoc]
2017-10-04 DSP Schematic Updates
    [DSP_Board.SchDoc, DSP_Power.SchDoc, TMS320F28335_DSP.SchDoc, XDS_100_USB_Programmer.SchDoc]
2017-10-08 Schematic Updates & Parts List Updates
    [Audio_ADC.SchDoc, DSP_Power.SchDoc, Senior_Project_PCB.PrjPcb, TMS320F28335_DSP.SchDoc, partsList.xlsx]
2017-10-08 Schematic Updates
    [Audio_ADC.SchDoc, DSP_Board_Headers.SchDoc, DSP_Power.SchDoc, TMS320F28335_DSP.SchDoc]
2017-10-10 Schematics Updates, No Compile Errors
    [DSP_Board_Headers.SchDoc, DSP_Power.SchDoc, Senior_Project_PCB.PrjPcb]
2017-10-10 Added ADC Footprint, Schematic Updates, Layout Updates
    [8VSSOP.PcbLib, Audio_ADC.SchDoc, DSP_Board.PcbDoc, DSP_Board_Headers.SchDoc, SFE-Custom-Footprints.PcbLib, TMS320F28335GF.PcbLib, TMS320F28335GF.SCHLIB]
2017-10-10 Schematic Updates & PCB Updates
    [Audio_ADC.SchDoc, DSP_Board.PcbDoc, DSP_Board_Headers.SchDoc, DSP_Power.SchDoc, TMS320F28335_DSP.SchDoc]
2017-10-11 PCB Updates
    [Audio_ADC.SchDoc, DSP_Board.PcbDoc, TMS320F28335_DSP.SchDoc]
2017-10-15 PCB Updates, JTAG HEader
    [DSP_Board.PcbDoc]
2017-10-20 push -me daddy
    PCB major update Switch 4.0
    [Audio_ADC.SchDoc, DSP_Board.PcbDoc, DSP_Board_Headers.SchDoc]
2017-10-20 Repo Restructure
    [8VSSOP.PcbLib, Audio_ADC.CSV, Audio_ADC.SchDoc, C283x_DSP.SchDoc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]
2017-10-20 update PWM and SCI
    Added a functional project folder for ePWM and SCI
2017-10-20 Update pcb
    Analog completed
    [DSP_Board.PcbDoc, TMS320F28335_DSP.SchDoc]
2017-10-22 final ish
    update the pcp
    [DSP_Board.PcbDoc]
2017-10-25 Finished Routing, DRC Clean
    DRC is throwing non-issue warnings but all nets are good to go.
    [DSP_Board_AJA.PcbDoc, Senior_Project_PCB.PrjPcb]
2017-10-25 PCB tweaks and File Generation
    [Audio_ADC.SchDoc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]
2017-11-06 Major Software & Hardware Project changes
    DSP_BOARD_AJA is the bay area board we got
    [BIOS.obj, DSP2833x_ADC_cal.obj, DSP2833x_Adc.obj, DSP2833x_CpuTimers.obj, DSP2833x_DMA.obj, DSP2833x_DefaultIsr.obj, DSP2833x_EPwm.obj, DSP2833x_GlobalVariableDefs.obj]
2017-11-15 Added 3D pdf and 3d STEP file as well as solidworks parts
    [DSP_Board_AJA.SLDPRT, DSP_Board_AJA.step]
2017-11-15 Update Code
    [EEL4511_CircBuff.obj]
2017-11-16 pushed adc
    internal adc for one channel
2017-11-21 BaseLine 11/20/17
    [BIOS.obj, DSP2833x_ADC_cal.obj, DSP2833x_Adc.obj, DSP2833x_CpuTimers.obj, DSP2833x_DMA.obj, DSP2833x_DefaultIsr.obj, DSP2833x_EPwm.obj, DSP2833x_GlobalVariableDefs.obj]
2017-11-22 update 2.11 revise main and added new classes
    last thing to do is to fix adc's and finalize songs
    [DSP2833x_ADC_cal.obj, DSP2833x_Adc.obj, DSP2833x_Sci.obj, USARTinit.obj, actuatorControl.obj]
2017-11-25 Added ESP Software and SolidWorks Files
    [BackWall.SLDPRT, BaseBoard.SLDPRT, Ceiling.SLDPRT, DSP_Board_AJA.SLDPRT, ESP32_RF_INIT.xlsx, ESP8266_RF_init.xls, ESP8266_RF_init.xlsx, Fan.SLDPRT]
2017-11-25 Updated PLLCLK frequency and enabled boot from Flash
    [BIOS.obj, DSP2833x_ADC_cal.obj, DSP2833x_Adc.obj, DSP2833x_CpuTimers.obj, DSP2833x_DMA.obj, DSP2833x_DefaultIsr.obj, DSP2833x_EPwm.obj, DSP2833x_GlobalVariableDefs.obj]
2017-11-27 fix my branch and ADC
    updating the 4-channel sequenced adc
    [internalADC.h]
2017-11-27 ADC preprocessing statements
    fix compile to main.c
    [ADC_names.cpp]
2017-11-30 kyle sucks
    upload sensor altium docs
    [Sensors.PrjPcb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]
2017-11-30 schematic update
    pcb and schematic for sensors
    [Sensors.PcbDoc, Sensors.SchDoc]
2017-12-04 Update SolidWorks Roof files
    change to 12 inch rooftop and 4.5 inch fan diameter
    [RoofSide.SLDPRT, RoofTop.SLDPRT]
2017-12-07 Add DSP and ESP SW FlowCharts
2017-12-07 Updated mag sensor schematic
    [AD22151.SchLib, Senior_DoorLock.PcbDoc, Senior_DoorLock.PrjPcb, Senior_DoorLock.SchDoc, Sensors.PrjPcb]
2017-12-07 hardware diagram
    overview flowchart
